alissssia/Flip-and-Patch/README.md

# Flipping and Patching - Implementation of hardware techniques for permanent fault tolerance in on-chip memories of CNN accelerators
This repository contains the implementation of two techniques for permanent fault tolerance in on-chip memories of CNN accelerators, addressing faults caused by voltage scaling. 
These mechanisms are described in the paper:
> **"Flip-and-Patch: A Fault-Tolerant Technique for On-Chip Memories of CNN Accelerators at Low Supply Voltage"**

### Citation (BibTeX)
```bibtex
@article{TOCADIAZ2024105023,
title = {Flip-and-Patch: A fault-tolerant technique for on-chip memories of CNN accelerators at low supply voltage},
journal = {Microprocessors and Microsystems},
volume = {106},
pages = {105023},
year = {2024},
issn = {0141-9331},
doi = {https://doi.org/10.1016/j.micpro.2024.105023},
url = {https://www.sciencedirect.com/science/article/pii/S0141933124000188},
author = {Yamilka Toca-Díaz and Reynier {Hernández Palacios} and Rubén {Gran Tejero} and Alejandro Valero}
}

@INPROCEEDINGS{10456839,
  author={Toca-Díaz, Yamilka and Muñoz, Nicolás Landeros and Tejero, Rubén Gran and Valero, Alejandro},
  booktitle={2023 26th Euromicro Conference on Digital System Design (DSD)}, 
  title={On Fault-Tolerant Microarchitectural Techniques for Voltage Underscaling in On-Chip Memories of CNN Accelerators}, 
  year={2023},
  volume={},
  number={},
  pages={138-145},
  keywords={Energy consumption;Low voltage;Microarchitecture;Manufacturing processes;System performance;Memory management;Voltage;Deep learning;energy efficiency;network accuracy;permanent faults},
  doi={10.1109/DSD60849.2023.00029}}
```

# Project organization
## Implementation
This directory contains different directories with each feature necessary to make the techniques work.
### flipping_mecanism
Contains the implementation of the flipping mechanism, which can be used:

- With a single activation,

- With a block of N activations or

- With flip-flops before and after the mechanism.

The directory also includes different flip-flop implementations, a multiplexer and dedicated testbenches (with a Makefile to execute all of them).

### cache
Implements the cache required for the patching mechanism.
Includes all necessary modules, a C++ testbench to verify correct functionality and a corresponding Makefile for the testbench execution.

### patching_mechanism
Contains the implementation of the patching mechanism, which ca be used:

- With a single activation,

- With a block of N activations or

- As a full mechanism that first fills up the whole cache and then reads.

The directory also includes a multiplexer and dedicated testbenches (with a Makefile to execute all of them).

### memory_classification
Contains the modules used for memory fault classification. The memory is:

- Written entirely with 0s to detect faulty cells

- Written entirely with 1s to detect faulty cells

Based on the observed errors, the f and p bits are generated so they can be used by the flipping and patching mechanisms.

The directory also includes testbench to test the sweep and a testbench to test the percentage of memory fails that shows the article mencioned above.

### final_integrated_test
Contains the final integration test, where all components are evaluated together:

- Memory classification

- Flipping mechanism

- Patching mechanism

This represents the complete Flip-and-Patch workflow.

### test_fpga
Includes the FPGA-based validation of the flipping and patching mechanisms.

Some modifications to the integration modules were required to adapt the design to FPGA constraints, and those changes are contained in this directory.

## Logisim Designs (.circ files)
In the root directory of the repository, several .circ files are provided. These files contain the Logisim designs of the cache, including:

- The cache architecture

- The cache architecture with BRAMs (representing how the cache would operate on an FPGA)

- Test circuits used to validate the correct functionality of the cache  

These schematics were used during the early design and validation stages to visually verify the behavior of the cache before its RTL implementation in SystemVerilog.

They can be opened and simulated using Logisim

## Thesis Document

The root directory also includes the PDF of my Bachelor’s Thesis (TFG) **in Spanish**, which provides a more detailed explanation of the complete work.  

The document describes:
- The theoretical background and motivation

- The design and implementation process of the flipping and patching mechanisms

- The cache design and state machines used
  
- Experimental setup and results  

For a deeper understanding of the design decisions and evaluation process, readers are encouraged to consult this document.

# Tool Versions

The following tools and versions were used during the design, implementation, and validation of this project:

- Visual Studio Code: v1.100.2  

- C++: v13.3.0  

- Verilator: v5.027  

- Logisim: v2.7.1  

- Operating System: Ubuntu 24.04  

- AMD Vivado Design Suite: v2024.2  

- FPGA Platform: ZedBoard (Zynq-7000)
