alissssia/Flip-and-Patch/(list of files, drawings)

Other design files:
cache_brams.circ
cache_TFG.circ
test2_cache.circ
test_cache.circ
test_cache_brams.circ
