alissssia/Flip-and-Patch/implementation/flipping_mechanism/flipflop_one.sv

`ifndef FLIPFLOP_UNO_SV
`define FLIPFLOP_UNO_SV
/* flipflop for one component of 1 bit */

module flipflop_one (input clk, rst, d,
                     output reg q);
    always_ff @(posedge clk or posedge rst) begin
        if (rst) begin
            q <= 1'b0;
        end else begin
            q <= d;
        end
    end
endmodule

`endif
