alissssia/Flip-and-Patch/implementation/flipping_mechanism/flipping_mechanism_one.sv

`ifndef FLIPPING_MECHANISM_ONE_SV
`define FLIPPING_MECHANISM_ONE_SV

module flipping_mechanism_one 
    #(parameter N = 16)
        (   input [N - 1:0] a, input f,
            output [N - 1:0] b);

    genvar i;

    generate;
        for (i = 0; i < N; i++) begin
            mux u0 (.a(a[i]), .b(a[N - 1 - i]), .sel(f), .eleccion(b[i]));
        end
    endgenerate

endmodule

`endif // FLIPPING_MECHANISM_ONE_SV
