alissssia/Flip-and-Patch/implementation/flipping_mechanism/flipflop_one_nbits.sv

`ifndef FLIPFLOP_ONE_NBITS_SV
`define FLIPFLOP_ONE_NBITS_SV
/* flipflop for one component of 16 (N) bits */

module flipflop_one_nbits
    #(parameter N = 16)
    (   input clk, rst, [N - 1:0] d,
        output logic [N - 1:0] q);
    always_ff @(posedge clk or posedge rst) begin
        if (rst) begin
            q <= 16'b0000000000000000;
        end else begin
            q <= d;
        end
    end
endmodule

`endif // FLIPFLOP_ONE_NBITS_SV
